Fabien-B/soufflerie_dashboard/soufflerie.kicad_pcb

## KiCad design soufflerie.kicad_pcb (2024-04-11)

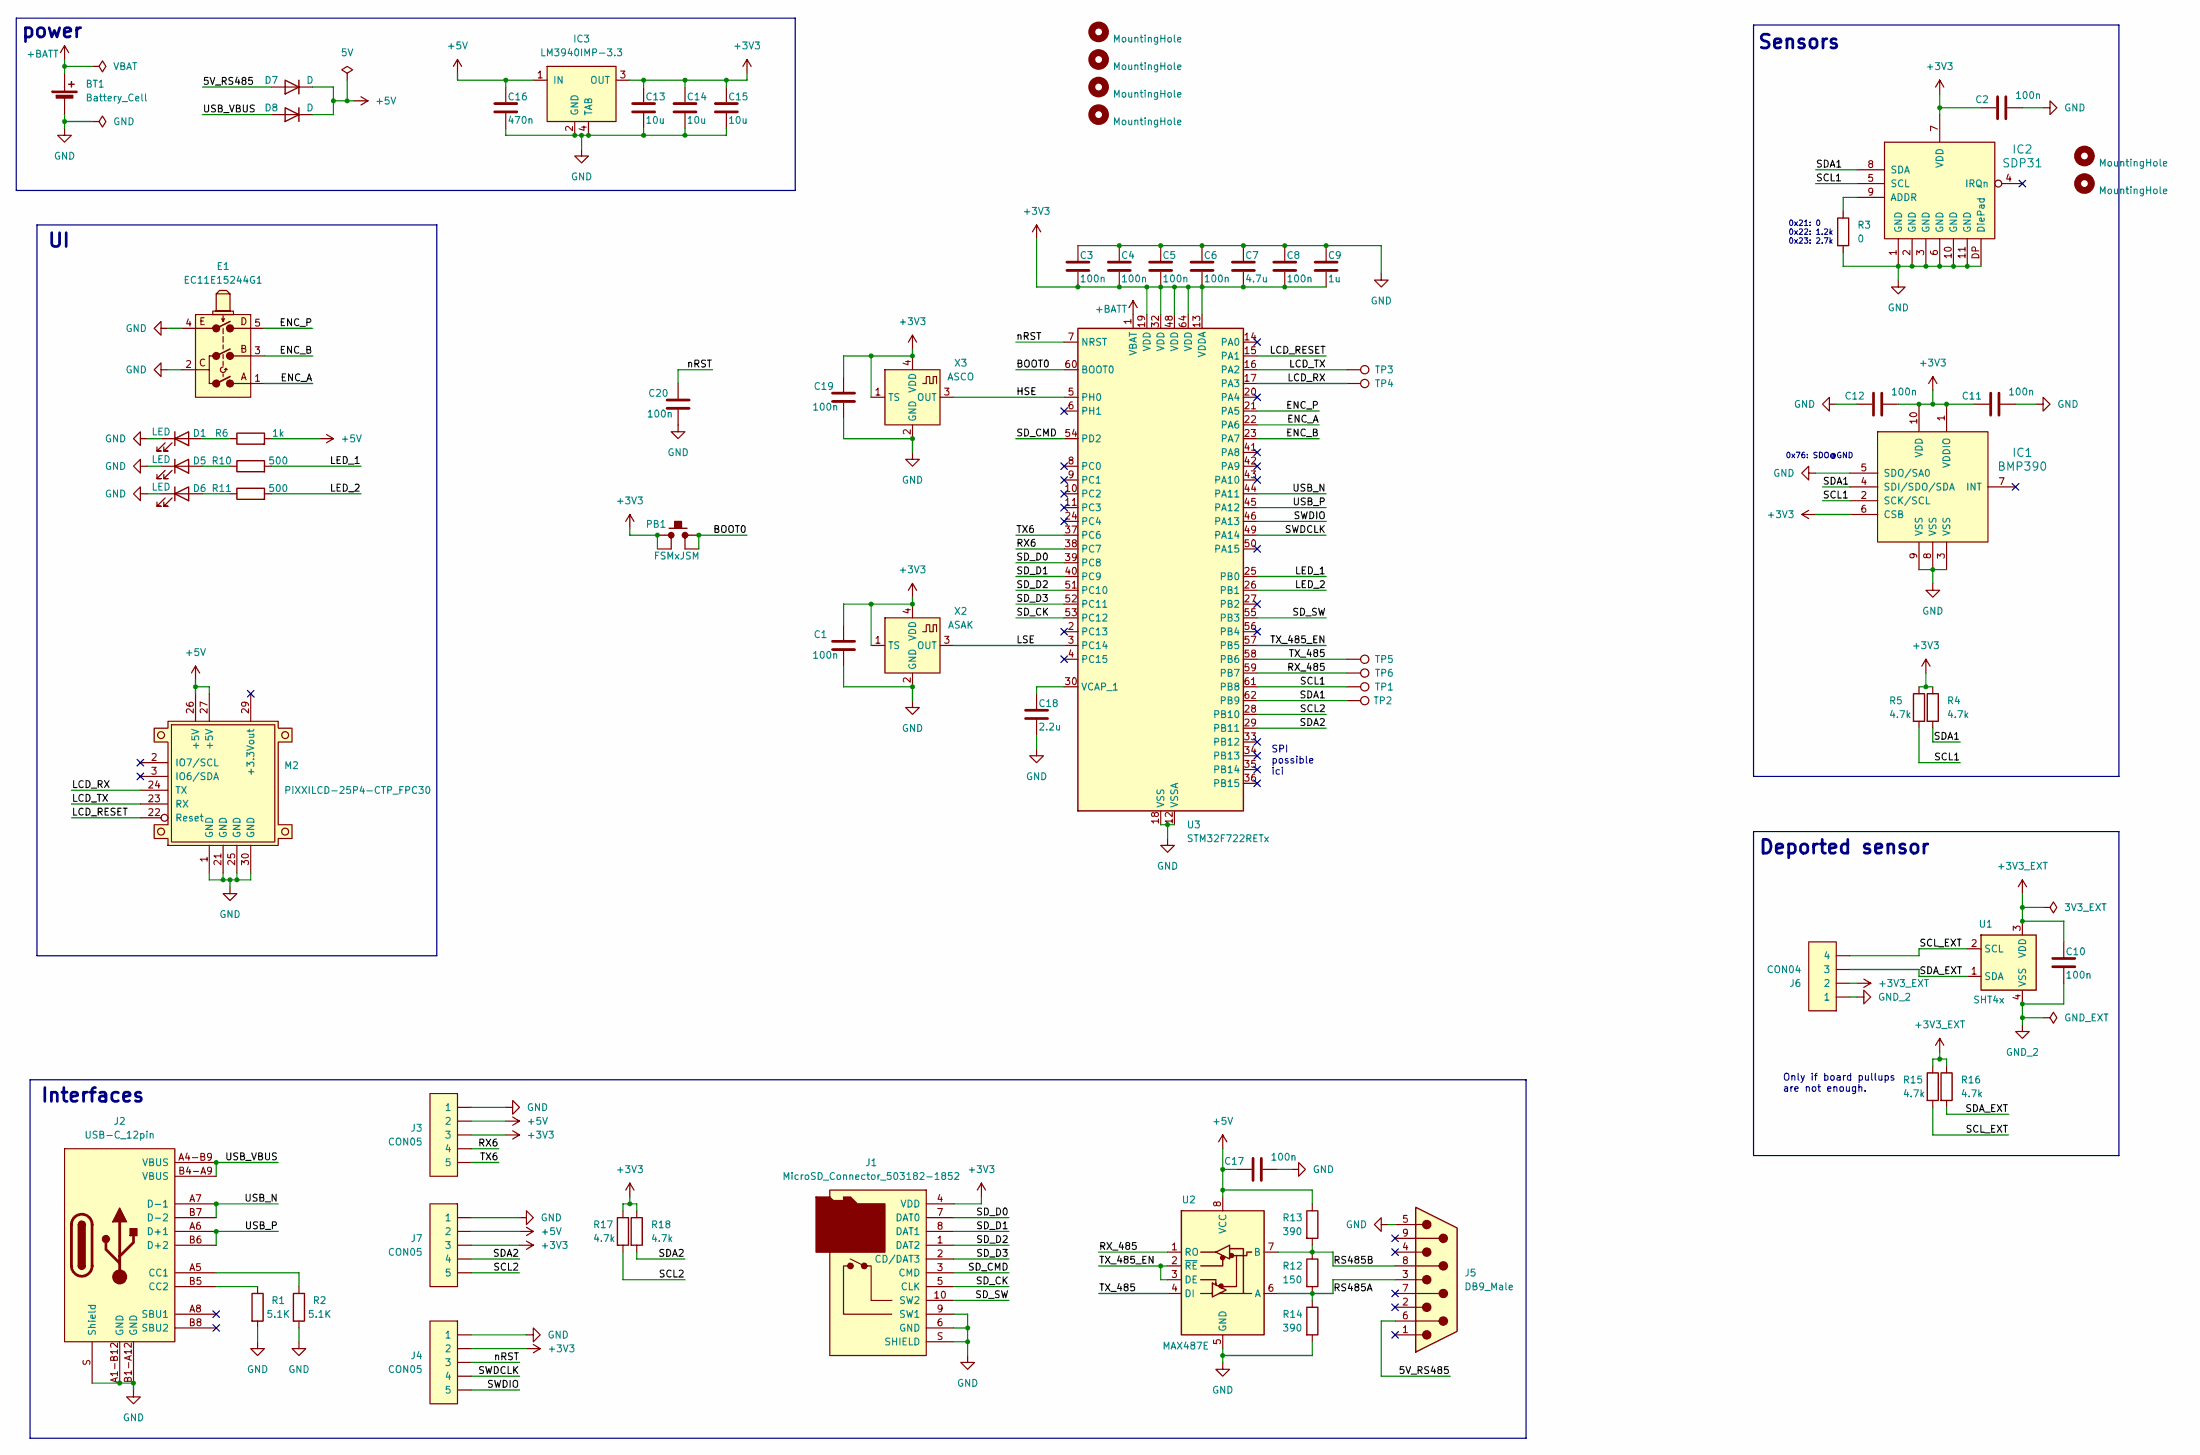
[picture p1: schematic soufflerie.kicad_sch]

Parts:
BT1: Battery_Cell; BatteryHolder_Keystone_3000_1x12mm
C1, C2, C3, C4, C5, C6, C8, C10, C11, C12, C17, C19, C20: 100n; C_0603_1608Metric
C7: 4.7u; C_0603_1608Metric
C9: 1u; C_0603_1608Metric
C13, C14, C15: 10u; C_0603_1608Metric
C16: 470n; C_0603_1608Metric
C18: 2.2u; C_0603_1608Metric
D1, D5, D6: LED; LED_0603_1608Metric
D7, D8: D; PMEG2010EB
E1: EC11E15244G1
H1, H2, H3, H4: MountingHole; MountingHole_3.2mm_M3
H5, H6: MountingHole; MountingHole_2.2mm_M2
IC1: BMP390
IC2: SDP31
IC3: LM3940IMP-3.3; LM3940IMP
J1: MicroSD_Connector_503182-1852; MicroSD_503182-1852
J2: USB-C_12pin; USB-C_HRO_C-31-M-12
J3, J4, J7: CON05; PicoBlade_53398-0571
J5: DB9_Male; DSUB-9_Male_Horizontal_P2.77x2.84mm_EdgePinOffset7.70mm_Hou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
J6: CON04; PicoBlade_53398-0471
M2: PIXXILCD-25P4-CTP_FPC30
PB1: FSMxJSM; FSM2JSM
R1, R2: 5.1K; R_0603_1608Metric
R3: 0; R_0603_1608Metric
R4, R5, R15, R16, R17, R18: 4.7k; R_0603_1608Metric
R6: 1k; R_0603_1608Metric
R10, R11: 500; R_0603_1608Metric
R12: 150; R_0603_1608Metric
R13, R14: 390; R_0603_1608Metric
TP1, TP2, TP3, TP4, TP5, TP6: TestPoint; TestPoint_Pad_D2.0mm
U1: SHT4x; Sensirion_DFN-4_1.5x1.5mm_P0.8mm_SHT4x_NoCentralPad
U2: MAX487E; SOIC-8_3.9x4.9mm_P1.27mm
U3: STM32F722RETx; LQFP-64_10x10mm_P0.5mm
X2: ASAK; Osc_ASAK
X3: ASCO; Osc_ASCO

Connections:
+3V3: C1.1, C2.1, C3.2, C4.2, C5.2, C6.2, C7.2, C8.2, C9.2, C11.1, C12.2, C13.1, C14.1, C15.1, C19.1, IC1.1 (VDDIO), IC1.6 (CSB), IC1.10 (VDD), IC2.7 (VDD), IC3.3 (OUT), J1.4 (VDD), J3.3, J4.2, J7.3, PB1.1, PB1.2, R4.1, R5.1, R17.1, R18.1, U3.13 (VDDA), U3.19 (VDD), U3.32 (VDD), U3.48 (VDD), U3.64 (VDD), X2.1 (TS), X2.4 (VDD), X3.1 (TS), X3.4 (VDD)
+3V3_EXT: C10.1, J6.2, R15.1, R16.1, U1.3 (VDD)
+5V: C16.1, C17.1, D7.1 (K), D8.1 (K), IC3.1 (IN), J3.2, J7.2, M2.26 (+5V), M2.27 (+5V), R6.2, R13.1, U2.8 (VCC)
+BATT: BT1.1 (+), U3.1 (VBAT)
/5V_RS485: D7.2 (A), J5.6
/BOOT0: PB1.3, PB1.4, U3.60 (BOOT0)
/ENC_A: E1.1, U3.22 (PA6)
/ENC_B: E1.3, U3.23 (PA7)
/ENC_P: E1.5, U3.21 (PA5)
/HSE: U3.5 (PH0), X3.3 (OUT)
/LCD_RESET: M2.22 (Reset), U3.15 (PA1)
/LCD_RX: M2.24 (TX), TP4.1, U3.17 (PA3)
/LCD_TX: M2.23 (RX), TP3.1, U3.16 (PA2)
/LED_1: R10.2, U3.25 (PB0)
/LED_2: R11.2, U3.26 (PB1)
/LSE: U3.3 (PC14), X2.3 (OUT)
/RS485A: J5.3, R12.2, R14.1, U2.6 (A)
/RS485B: J5.8, R12.1, R13.2, U2.7 (B)
/RX6: J3.4, U3.38 (PC7)
/RX_485: TP6.1, U2.1 (RO), U3.59 (PB7)
/SCL1: IC1.2 (SCK/SCL), IC2.5 (SCL), R5.2, TP1.1, U3.61 (PB8)
/SCL2: J7.5, R17.2, U3.28 (PB10)
/SCL_EXT: J6.4, R15.2, U1.2 (SCL)
/SDA1: IC1.4 (SDI/SDO/SDA), IC2.8 (SDA), R4.2, TP2.1, U3.62 (PB9)
/SDA2: J7.4, R18.2, U3.29 (PB11)
/SDA_EXT: J6.3, R16.2, U1.1 (SDA)
/SD_CK: J1.5 (CLK), U3.53 (PC12)
/SD_CMD: J1.3 (CMD), U3.54 (PD2)
/SD_D0: J1.7 (DAT0), U3.39 (PC8)
/SD_D1: J1.8 (DAT1), U3.40 (PC9)
/SD_D2: J1.1 (DAT2), U3.51 (PC10)
/SD_D3: J1.2 (CD/DAT3), U3.52 (PC11)
/SD_SW: J1.10 (SW2), U3.55 (PB3)
/SWDCLK: J4.4, U3.49 (PA14)
/SWDIO: J4.5, U3.46 (PA13)
/TX6: J3.5, U3.37 (PC6)
/TX_485: TP5.1, U2.4 (DI), U3.58 (PB6)
/TX_485_EN: U2.2 (~RE), U2.3 (DE), U3.57 (PB5)
/USB_N: J2.A7 (D-1), J2.B7 (D-2), U3.44 (PA11)
/USB_P: J2.A6 (D+1), J2.B6 (D+2), U3.45 (PA12)
/USB_VBUS: D8.2 (A), J2.A4-B9 (VBUS), J2.B4-A9 (VBUS)
/nRST: C20.1, J4.3, U3.7 (NRST)
GND: BT1.2 (-), C1.2, C2.2, C3.1, C4.1, C5.1, C6.1, C7.1, C8.1, C9.1, C11.2, C12.1, C13.2, C14.2, C15.2, C16.2, C17.2, C18.2, C19.2, C20.2, D1.1 (K), D5.1 (K), D6.1 (K), E1.2, E1.4, IC1.3 (VSS), IC1.5 (SDO/SA0), IC1.8 (VSS), IC1.9 (VSS), IC2.1 (GND), IC2.2 (GND), IC2.3 (GND), IC2.6 (GND), IC2.10 (GND), IC2.11 (GND), IC2.DP (DiePad), IC3.2 (GND), IC3.4 (TAB), J1.6 (GND), J1.9 (SW1), J1.S (SHIELD), J2.A1-B12 (GND), J2.B1-A12 (GND), J2.S (Shield), J3.1, J4.1, J5.5, J7.1, M2.1 (GND), M2.21 (GND), M2.25 (GND), M2.30 (GND), R1.2, R2.2, R3.2, R14.2, U2.5 (GND), U3.12 (VSSA), U3.18 (VSS), U3.31 (VSS), U3.47 (VSS), U3.63 (VSS), X2.2 (GND), X3.2 (GND)
GND_2: C10.2, J6.1, U1.4 (VSS)
unnamed: D1.2 (A), R6.1
unnamed: D5.2 (A), R10.1
unnamed: D6.2 (A), R11.1
unnamed: IC2.9 (ADDR), R3.1
unnamed: J2.A5 (CC1), R2.1
unnamed: J2.B5 (CC2), R1.1
unnamed: C18.1, U3.30 (VCAP_1)

Notes on the sheet:
Interfaces
Only if board pullups are not enough.
0x76: SDO@GND
SPI possible ici
0x21: 0 0x22: 1.2k 0x23: 2.7k
Sensors
Deported sensor
power

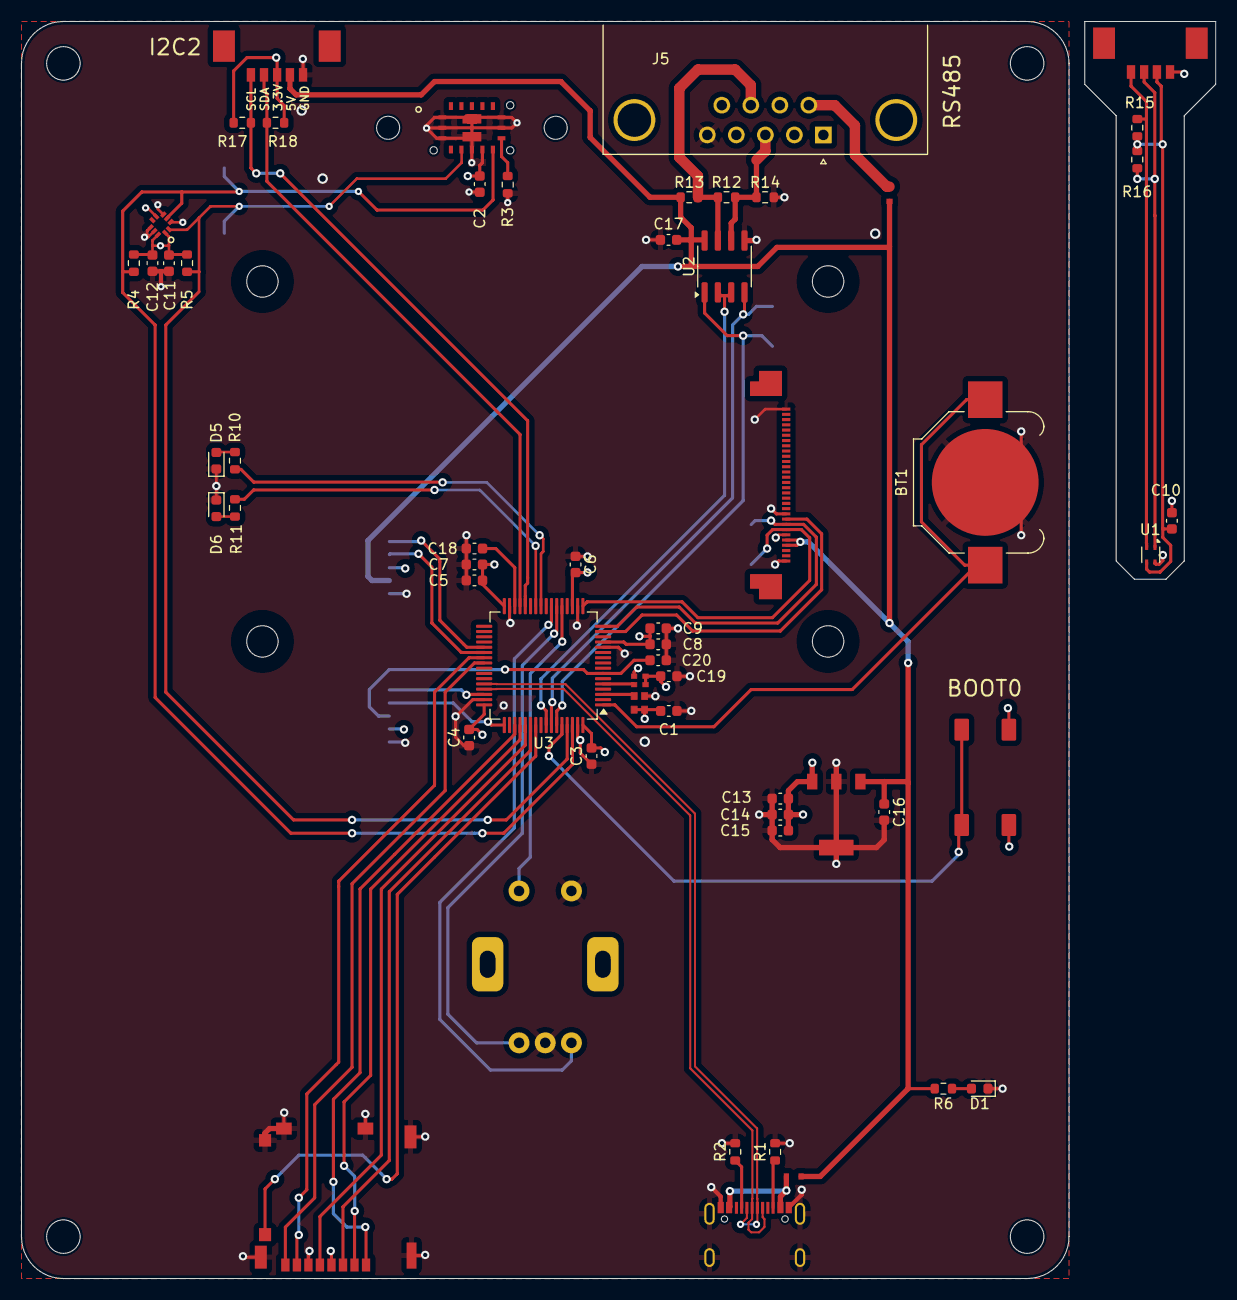
[picture p2: board soufflerie.kicad_pcb from above]

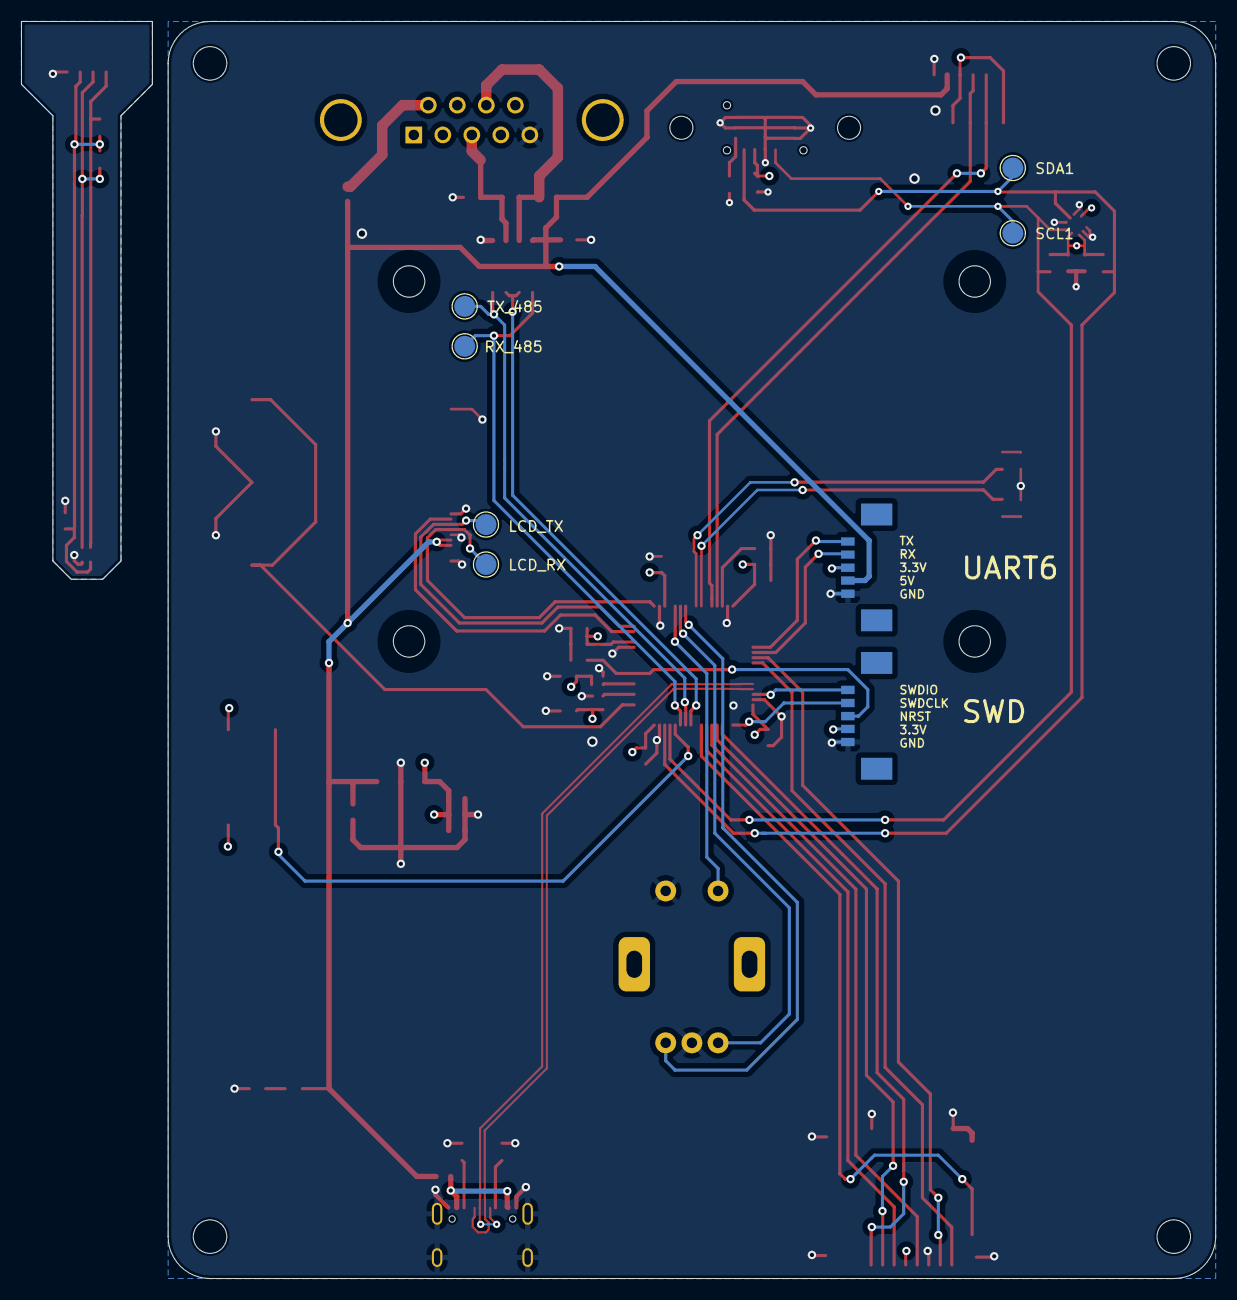
[picture p3: board soufflerie.kicad_pcb from below]

Board: 4 copper layers, 100.0 x 120.0 mm, 71 parts (8 on the bottom side), 51 nets.
