Fabien-B/soufflerie_dashboard/firmware/source/main.cpp

/*
    ChibiOS - Copyright (C) 2006..2018 Giovanni Di Sirio

    Licensed under the Apache License, Version 2.0 (the "License");
    you may not use this file except in compliance with the License.
    You may obtain a copy of the License at

        http://www.apache.org/licenses/LICENSE-2.0

    Unless required by applicable law or agreed to in writing, software
    distributed under the License is distributed on an "AS IS" BASIS,
    WITHOUT WARRANTIES OR CONDITIONS OF ANY KIND, either express or implied.
    See the License for the specific language governing permissions and
    limitations under the License.
*/

#include "ch.h"
#include "hal.h"
#include "display.h"
#include "stdutil++.hpp"
#include "sensors.h"
#include "sd.h"
#include "ttyConsole.h"
#include "uss_handler.h"


SerialConfig sd6_conf = {
  .speed = 115200,
  .cr1 = 0,
  .cr2 = USART_CR2_STOP1_BITS | USART_CR2_LINEN,
  .cr3 = 0
};


/*
 * This is a periodic thread that does absolutely nothing except flashing
 * a LED.
 */
static THD_WORKING_AREA(waThread1, 512);
static THD_FUNCTION(Thread1, arg) {

  (void)arg;
  chRegSetThreadName("blinker");

  while (true) {
    chThdSleepMilliseconds(200);
  }
}




/*
 * Application entry point.
 */
int main(void) {

  /*
   * System initializations.
   * - HAL initialization, this also initializes the configured device drivers
   *   and performs the board-specific initializations.
   * - Kernel initialization, the main() function becomes a thread and the
   *   RTOS is active.
   */
  halInit();
  chSysInit();
  initHeap();

  consoleInit();
  startSensors();
  startUSSListener();
  startUI();
  

  /*
   * Creates the example thread.
   */
  chThdCreateStatic(waThread1, sizeof(waThread1), NORMALPRIO + 1, Thread1, NULL);

  consoleLaunch();

  while (true) {
    chThdSleepMilliseconds(500);
  }
}
