Fabien-B/soufflerie_dashboard/firmware/cfg/board.h

/*
    ChibiOS - Copyright (C) 2006..2015 Giovanni Di Sirio

    Licensed under the Apache License, Version 2.0 (the "License");
    you may not use this file except in compliance with the License.
    You may obtain a copy of the License at

        http://www.apache.org/licenses/LICENSE-2.0

    Unless required by applicable law or agreed to in writing, software
    distributed under the License is distributed on an "AS IS" BASIS,
    WITHOUT WARRANTIES OR CONDITIONS OF ANY KIND, either express or implied.
    See the License for the specific language governing permissions and
    limitations under the License.
*/

#pragma once

/*
 * Board identifier.
 */
#define BOARD_SOUFFLERIE
#define BOARD_NAME                  "Soufflerie"

/*
 * Board oscillators-related settings.
 */
#if !defined(STM32_LSECLK)
#define STM32_LSECLK                32768
#define STM32_LSE_BYPASS           TRUE
#endif

#define STM32_LSEDRV                (3U << 3U)

#if !defined(STM32_HSECLK)
#define STM32_HSECLK                8000000U
#define STM32_HSE_BYPASS            TRUE
#endif


/*
 * Board voltages.
 * Required for performance limits calculation.
 */
#define STM32_VDD                   300U

/*
 * MCU type as defined in the ST header.
 */
#define STM32F722xx

/*
 * IO pins assignments.
 */
#define	PA00                           0U
#define	PA01_LCD_RESET                 1U
#define	PA02_LCD_TX                    2U
#define	PA03_LCD_RX                    3U
#define	PA04                           4U
#define	PA05_ENC_PUSH                  5U
#define	PA06_ENC_A                     6U
#define	PA07_ENC_B                     7U
#define	PA08                           8U
#define	PA09                           9U
#define	PA10                           10U
#define	PA11_USB_DM                    11U
#define	PA12_USB_DP                    12U
#define	PA13_SWDIO                     13U
#define	PA14_SWCLK                     14U
#define	PA15                           15U

#define	PB00_LED1                      0U
#define	PB01_LED2                      1U
#define	PB02                           2U
#define	PB03_SD_SW                     3U
#define	PB04                           4U
#define	PB05_TX485EN                   5U
#define	PB06_TX485                     6U
#define	PB07_RS485                     7U
#define	PB08_I2C1_SCL                  8U
#define	PB09_I2C1_SDA                  9U
#define	PB10_I2C2_SCL                  10U
#define	PB11_I2C2_SDA                  11U
#define	PB12                           12U
#define	PB13                           13U
#define	PB14                           14U
#define	PB15                           15U

#define	PC00                           0U
#define	PC01                           1U
#define	PC02                           2U
#define	PC03                           3U
#define	PC04                           4U
#define	PC05                           5U
#define	PC06_UART6_TX                  6U
#define	PC07_UART6_RX                  7U
#define	PC08_SD_D0                     8U
#define	PC09_SD_D1                     9U
#define	PC10_SD_D2                     10U
#define	PC11_SD_D3                     11U
#define	PC12_SD_CK                     12U
#define	PC13                           13U
#define	PC14_OSC32_IN                  14U
#define	PC15                           15U

#define	PD00                           0U
#define	PD01                           1U
#define	PD02_SD_CMD                    2U
#define	PD03                           3U
#define	PD04                           4U
#define	PD05                           5U
#define	PD06                           6U
#define	PD07                           7U
#define	PD08                           8U
#define	PD09                           9U
#define	PD10                           10U
#define	PD11                           11U
#define	PD12                           12U
#define	PD13                           13U
#define	PD14                           14U
#define	PD15                           15U

#define	PE00                           0U
#define	PE01                           1U
#define	PE02                           2U
#define	PE03                           3U
#define	PE04                           4U
#define	PE05                           5U
#define	PE06                           6U
#define	PE07                           7U
#define	PE08                           8U
#define	PE09                           9U
#define	PE10                           10U
#define	PE11                           11U
#define	PE12                           12U
#define	PE13                           13U
#define	PE14                           14U
#define	PE15                           15U

#define	PF00                           0U
#define	PF01                           1U
#define	PF02                           2U
#define	PF03                           3U
#define	PF04                           4U
#define	PF05                           5U
#define	PF06                           6U
#define	PF07                           7U
#define	PF08                           8U
#define	PF09                           9U
#define	PF10                           10U
#define	PF11                           11U
#define	PF12                           12U
#define	PF13                           13U
#define	PF14                           14U
#define	PF15                           15U

#define	PG00                           0U
#define	PG01                           1U
#define	PG02                           2U
#define	PG03                           3U
#define	PG04                           4U
#define	PG05                           5U
#define	PG06                           6U
#define	PG07                           7U
#define	PG08                           8U
#define	PG09                           9U
#define	PG10                           10U
#define	PG11                           11U
#define	PG12                           12U
#define	PG13                           13U
#define	PG14                           14U
#define	PG15                           15U

#define	PH00_OSC_IN                    0U
#define	PH01                           1U
#define	PH02                           2U
#define	PH03                           3U
#define	PH04                           4U
#define	PH05                           5U
#define	PH06                           6U
#define	PH07                           7U
#define	PH08                           8U
#define	PH09                           9U
#define	PH10                           10U
#define	PH11                           11U
#define	PH12                           12U
#define	PH13                           13U
#define	PH14                           14U
#define	PH15                           15U

#define	PI00                           0U
#define	PI01                           1U
#define	PI02                           2U
#define	PI03                           3U
#define	PI04                           4U
#define	PI05                           5U
#define	PI06                           6U
#define	PI07                           7U
#define	PI08                           8U
#define	PI09                           9U
#define	PI10                           10U
#define	PI11                           11U
#define	PI12                           12U
#define	PI13                           13U
#define	PI14                           14U
#define	PI15                           15U

#define	PJ00                           0U
#define	PJ01                           1U
#define	PJ02                           2U
#define	PJ03                           3U
#define	PJ04                           4U
#define	PJ05                           5U
#define	PJ06                           6U
#define	PJ07                           7U
#define	PJ08                           8U
#define	PJ09                           9U
#define	PJ10                           10U
#define	PJ11                           11U
#define	PJ12                           12U
#define	PJ13                           13U
#define	PJ14                           14U
#define	PJ15                           15U

#define	PK00                           0U
#define	PK01                           1U
#define	PK02                           2U
#define	PK03                           3U
#define	PK04                           4U
#define	PK05                           5U
#define	PK06                           6U
#define	PK07                           7U
#define	PK08                           8U
#define	PK09                           9U
#define	PK10                           10U
#define	PK11                           11U
#define	PK12                           12U
#define	PK13                           13U
#define	PK14                           14U
#define	PK15                           15U

/*
 * IO lines assignments.
 */
#define	LINE_LCD_RESET                 PAL_LINE(GPIOA, 1U)
#define	LINE_LCD_TX                    PAL_LINE(GPIOA, 2U)
#define	LINE_LCD_RX                    PAL_LINE(GPIOA, 3U)
#define	LINE_ENC_PUSH                  PAL_LINE(GPIOA, 5U)
#define	LINE_ENC_A                     PAL_LINE(GPIOA, 6U)
#define	LINE_ENC_B                     PAL_LINE(GPIOA, 7U)
#define	LINE_USB_DM                    PAL_LINE(GPIOA, 11U)
#define	LINE_USB_DP                    PAL_LINE(GPIOA, 12U)
#define	LINE_SWDIO                     PAL_LINE(GPIOA, 13U)
#define	LINE_SWCLK                     PAL_LINE(GPIOA, 14U)

#define	LINE_LED1                      PAL_LINE(GPIOB, 0U)
#define	LINE_LED2                      PAL_LINE(GPIOB, 1U)
#define	LINE_SD_SW                     PAL_LINE(GPIOB, 3U)
#define	LINE_TX485EN                   PAL_LINE(GPIOB, 5U)
#define	LINE_TX485                     PAL_LINE(GPIOB, 6U)
#define	LINE_RS485                     PAL_LINE(GPIOB, 7U)
#define	LINE_I2C1_SCL                  PAL_LINE(GPIOB, 8U)
#define	LINE_I2C1_SDA                  PAL_LINE(GPIOB, 9U)
#define	LINE_I2C2_SCL                  PAL_LINE(GPIOB, 10U)
#define	LINE_I2C2_SDA                  PAL_LINE(GPIOB, 11U)

#define	LINE_UART6_TX                  PAL_LINE(GPIOC, 6U)
#define	LINE_UART6_RX                  PAL_LINE(GPIOC, 7U)
#define	LINE_SD_D0                     PAL_LINE(GPIOC, 8U)
#define	LINE_SD_D1                     PAL_LINE(GPIOC, 9U)
#define	LINE_SD_D2                     PAL_LINE(GPIOC, 10U)
#define	LINE_SD_D3                     PAL_LINE(GPIOC, 11U)
#define	LINE_SD_CK                     PAL_LINE(GPIOC, 12U)
#define	LINE_OSC32_IN                  PAL_LINE(GPIOC, 14U)

#define	LINE_SD_CMD                    PAL_LINE(GPIOD, 2U)

#define	LINE_OSC_IN                    PAL_LINE(GPIOH, 0U)


/*
 * I/O ports initial setup, this configuration is established soon after reset
 * in the initialization code.
 * Please refer to the STM32 Reference Manual for details.
 */
#define PIN_MODE_INPUT(n)           (0U << ((n) * 2U))
#define PIN_MODE_OUTPUT(n)          (1U << ((n) * 2U))
#define PIN_MODE_ALTERNATE(n)       (2U << ((n) * 2U))
#define PIN_MODE_ANALOG(n)          (3U << ((n) * 2U))
#define PIN_ODR_LEVEL_LOW(n)        (0U << (n))
#define PIN_ODR_LEVEL_HIGH(n)       (1U << (n))
#define PIN_OTYPE_PUSHPULL(n)       (0U << (n))
#define PIN_OTYPE_OPENDRAIN(n)      (1U << (n))
#define PIN_OSPEED_SPEED_VERYLOW(n) (0U << ((n) * 2U))
#define PIN_OSPEED_SPEED_LOW(n)     (1U << ((n) * 2U))
#define PIN_OSPEED_SPEED_MEDIUM(n)  (2U << ((n) * 2U))
#define PIN_OSPEED_SPEED_HIGH(n)    (3U << ((n) * 2U))
#define PIN_PUPDR_FLOATING(n)       (0U << ((n) * 2U))
#define PIN_PUPDR_PULLUP(n)         (1U << ((n) * 2U))
#define PIN_PUPDR_PULLDOWN(n)       (2U << ((n) * 2U))
#define PIN_AFIO_AF(n, v)           ((v) << (((n) % 8U) * 4U))

#define VAL_GPIOA_MODER                 (PIN_MODE_INPUT(PA00) | \
					 PIN_MODE_OUTPUT(PA01_LCD_RESET) | \
					 PIN_MODE_ALTERNATE(PA02_LCD_TX) | \
					 PIN_MODE_ALTERNATE(PA03_LCD_RX) | \
					 PIN_MODE_INPUT(PA04) | \
					 PIN_MODE_INPUT(PA05_ENC_PUSH) | \
					 PIN_MODE_ALTERNATE(PA06_ENC_A) | \
					 PIN_MODE_ALTERNATE(PA07_ENC_B) | \
					 PIN_MODE_INPUT(PA08) | \
					 PIN_MODE_INPUT(PA09) | \
					 PIN_MODE_INPUT(PA10) | \
					 PIN_MODE_ALTERNATE(PA11_USB_DM) | \
					 PIN_MODE_ALTERNATE(PA12_USB_DP) | \
					 PIN_MODE_ALTERNATE(PA13_SWDIO) | \
					 PIN_MODE_ALTERNATE(PA14_SWCLK) | \
					 PIN_MODE_INPUT(PA15))

#define VAL_GPIOA_OTYPER                (PIN_OTYPE_PUSHPULL(PA00) | \
					 PIN_OTYPE_PUSHPULL(PA01_LCD_RESET) | \
					 PIN_OTYPE_PUSHPULL(PA02_LCD_TX) | \
					 PIN_OTYPE_PUSHPULL(PA03_LCD_RX) | \
					 PIN_OTYPE_PUSHPULL(PA04) | \
					 PIN_OTYPE_OPENDRAIN(PA05_ENC_PUSH) | \
					 PIN_OTYPE_PUSHPULL(PA06_ENC_A) | \
					 PIN_OTYPE_PUSHPULL(PA07_ENC_B) | \
					 PIN_OTYPE_PUSHPULL(PA08) | \
					 PIN_OTYPE_PUSHPULL(PA09) | \
					 PIN_OTYPE_PUSHPULL(PA10) | \
					 PIN_OTYPE_PUSHPULL(PA11_USB_DM) | \
					 PIN_OTYPE_PUSHPULL(PA12_USB_DP) | \
					 PIN_OTYPE_PUSHPULL(PA13_SWDIO) | \
					 PIN_OTYPE_PUSHPULL(PA14_SWCLK) | \
					 PIN_OTYPE_PUSHPULL(PA15))

#define VAL_GPIOA_OSPEEDR               (PIN_OSPEED_SPEED_VERYLOW(PA00) | \
					 PIN_OSPEED_SPEED_VERYLOW(PA01_LCD_RESET) | \
					 PIN_OSPEED_SPEED_HIGH(PA02_LCD_TX) | \
					 PIN_OSPEED_SPEED_HIGH(PA03_LCD_RX) | \
					 PIN_OSPEED_SPEED_VERYLOW(PA04) | \
					 PIN_OSPEED_SPEED_VERYLOW(PA05_ENC_PUSH) | \
					 PIN_OSPEED_SPEED_HIGH(PA06_ENC_A) | \
					 PIN_OSPEED_SPEED_HIGH(PA07_ENC_B) | \
					 PIN_OSPEED_SPEED_VERYLOW(PA08) | \
					 PIN_OSPEED_SPEED_VERYLOW(PA09) | \
					 PIN_OSPEED_SPEED_VERYLOW(PA10) | \
					 PIN_OSPEED_SPEED_HIGH(PA11_USB_DM) | \
					 PIN_OSPEED_SPEED_HIGH(PA12_USB_DP) | \
					 PIN_OSPEED_SPEED_HIGH(PA13_SWDIO) | \
					 PIN_OSPEED_SPEED_HIGH(PA14_SWCLK) | \
					 PIN_OSPEED_SPEED_VERYLOW(PA15))

#define VAL_GPIOA_PUPDR                 (PIN_PUPDR_PULLDOWN(PA00) | \
					 PIN_PUPDR_FLOATING(PA01_LCD_RESET) | \
					 PIN_PUPDR_FLOATING(PA02_LCD_TX) | \
					 PIN_PUPDR_FLOATING(PA03_LCD_RX) | \
					 PIN_PUPDR_PULLDOWN(PA04) | \
					 PIN_PUPDR_PULLUP(PA05_ENC_PUSH) | \
					 PIN_PUPDR_FLOATING(PA06_ENC_A) | \
					 PIN_PUPDR_FLOATING(PA07_ENC_B) | \
					 PIN_PUPDR_PULLDOWN(PA08) | \
					 PIN_PUPDR_PULLDOWN(PA09) | \
					 PIN_PUPDR_PULLDOWN(PA10) | \
					 PIN_PUPDR_FLOATING(PA11_USB_DM) | \
					 PIN_PUPDR_FLOATING(PA12_USB_DP) | \
					 PIN_PUPDR_PULLUP(PA13_SWDIO) | \
					 PIN_PUPDR_PULLUP(PA14_SWCLK) | \
					 PIN_PUPDR_PULLDOWN(PA15))

#define VAL_GPIOA_ODR                   (PIN_ODR_LEVEL_LOW(PA00) | \
					 PIN_ODR_LEVEL_HIGH(PA01_LCD_RESET) | \
					 PIN_ODR_LEVEL_HIGH(PA02_LCD_TX) | \
					 PIN_ODR_LEVEL_HIGH(PA03_LCD_RX) | \
					 PIN_ODR_LEVEL_LOW(PA04) | \
					 PIN_ODR_LEVEL_LOW(PA05_ENC_PUSH) | \
					 PIN_ODR_LEVEL_HIGH(PA06_ENC_A) | \
					 PIN_ODR_LEVEL_HIGH(PA07_ENC_B) | \
					 PIN_ODR_LEVEL_LOW(PA08) | \
					 PIN_ODR_LEVEL_LOW(PA09) | \
					 PIN_ODR_LEVEL_LOW(PA10) | \
					 PIN_ODR_LEVEL_HIGH(PA11_USB_DM) | \
					 PIN_ODR_LEVEL_HIGH(PA12_USB_DP) | \
					 PIN_ODR_LEVEL_HIGH(PA13_SWDIO) | \
					 PIN_ODR_LEVEL_HIGH(PA14_SWCLK) | \
					 PIN_ODR_LEVEL_LOW(PA15))

#define VAL_GPIOA_AFRL			(PIN_AFIO_AF(PA00, 0) | \
					 PIN_AFIO_AF(PA01_LCD_RESET, 0) | \
					 PIN_AFIO_AF(PA02_LCD_TX, 7) | \
					 PIN_AFIO_AF(PA03_LCD_RX, 7) | \
					 PIN_AFIO_AF(PA04, 0) | \
					 PIN_AFIO_AF(PA05_ENC_PUSH, 0) | \
					 PIN_AFIO_AF(PA06_ENC_A, 2) | \
					 PIN_AFIO_AF(PA07_ENC_B, 2))

#define VAL_GPIOA_AFRH			(PIN_AFIO_AF(PA08, 0) | \
					 PIN_AFIO_AF(PA09, 0) | \
					 PIN_AFIO_AF(PA10, 0) | \
					 PIN_AFIO_AF(PA11_USB_DM, 10) | \
					 PIN_AFIO_AF(PA12_USB_DP, 10) | \
					 PIN_AFIO_AF(PA13_SWDIO, 0) | \
					 PIN_AFIO_AF(PA14_SWCLK, 0) | \
					 PIN_AFIO_AF(PA15, 0))

#define VAL_GPIOB_MODER                 (PIN_MODE_OUTPUT(PB00_LED1) | \
					 PIN_MODE_OUTPUT(PB01_LED2) | \
					 PIN_MODE_INPUT(PB02) | \
					 PIN_MODE_INPUT(PB03_SD_SW) | \
					 PIN_MODE_INPUT(PB04) | \
					 PIN_MODE_OUTPUT(PB05_TX485EN) | \
					 PIN_MODE_ALTERNATE(PB06_TX485) | \
					 PIN_MODE_ALTERNATE(PB07_RS485) | \
					 PIN_MODE_ALTERNATE(PB08_I2C1_SCL) | \
					 PIN_MODE_ALTERNATE(PB09_I2C1_SDA) | \
					 PIN_MODE_ALTERNATE(PB10_I2C2_SCL) | \
					 PIN_MODE_ALTERNATE(PB11_I2C2_SDA) | \
					 PIN_MODE_INPUT(PB12) | \
					 PIN_MODE_INPUT(PB13) | \
					 PIN_MODE_INPUT(PB14) | \
					 PIN_MODE_INPUT(PB15))

#define VAL_GPIOB_OTYPER                (PIN_OTYPE_PUSHPULL(PB00_LED1) | \
					 PIN_OTYPE_PUSHPULL(PB01_LED2) | \
					 PIN_OTYPE_PUSHPULL(PB02) | \
					 PIN_OTYPE_OPENDRAIN(PB03_SD_SW) | \
					 PIN_OTYPE_PUSHPULL(PB04) | \
					 PIN_OTYPE_PUSHPULL(PB05_TX485EN) | \
					 PIN_OTYPE_PUSHPULL(PB06_TX485) | \
					 PIN_OTYPE_PUSHPULL(PB07_RS485) | \
					 PIN_OTYPE_OPENDRAIN(PB08_I2C1_SCL) | \
					 PIN_OTYPE_OPENDRAIN(PB09_I2C1_SDA) | \
					 PIN_OTYPE_OPENDRAIN(PB10_I2C2_SCL) | \
					 PIN_OTYPE_OPENDRAIN(PB11_I2C2_SDA) | \
					 PIN_OTYPE_PUSHPULL(PB12) | \
					 PIN_OTYPE_PUSHPULL(PB13) | \
					 PIN_OTYPE_PUSHPULL(PB14) | \
					 PIN_OTYPE_PUSHPULL(PB15))

#define VAL_GPIOB_OSPEEDR               (PIN_OSPEED_SPEED_VERYLOW(PB00_LED1) | \
					 PIN_OSPEED_SPEED_VERYLOW(PB01_LED2) | \
					 PIN_OSPEED_SPEED_VERYLOW(PB02) | \
					 PIN_OSPEED_SPEED_VERYLOW(PB03_SD_SW) | \
					 PIN_OSPEED_SPEED_VERYLOW(PB04) | \
					 PIN_OSPEED_SPEED_VERYLOW(PB05_TX485EN) | \
					 PIN_OSPEED_SPEED_HIGH(PB06_TX485) | \
					 PIN_OSPEED_SPEED_HIGH(PB07_RS485) | \
					 PIN_OSPEED_SPEED_HIGH(PB08_I2C1_SCL) | \
					 PIN_OSPEED_SPEED_HIGH(PB09_I2C1_SDA) | \
					 PIN_OSPEED_SPEED_HIGH(PB10_I2C2_SCL) | \
					 PIN_OSPEED_SPEED_HIGH(PB11_I2C2_SDA) | \
					 PIN_OSPEED_SPEED_VERYLOW(PB12) | \
					 PIN_OSPEED_SPEED_VERYLOW(PB13) | \
					 PIN_OSPEED_SPEED_VERYLOW(PB14) | \
					 PIN_OSPEED_SPEED_VERYLOW(PB15))

#define VAL_GPIOB_PUPDR                 (PIN_PUPDR_FLOATING(PB00_LED1) | \
					 PIN_PUPDR_FLOATING(PB01_LED2) | \
					 PIN_PUPDR_PULLDOWN(PB02) | \
					 PIN_PUPDR_PULLUP(PB03_SD_SW) | \
					 PIN_PUPDR_PULLDOWN(PB04) | \
					 PIN_PUPDR_FLOATING(PB05_TX485EN) | \
					 PIN_PUPDR_FLOATING(PB06_TX485) | \
					 PIN_PUPDR_PULLUP(PB07_RS485) | \
					 PIN_PUPDR_PULLUP(PB08_I2C1_SCL) | \
					 PIN_PUPDR_PULLUP(PB09_I2C1_SDA) | \
					 PIN_PUPDR_PULLUP(PB10_I2C2_SCL) | \
					 PIN_PUPDR_PULLUP(PB11_I2C2_SDA) | \
					 PIN_PUPDR_PULLDOWN(PB12) | \
					 PIN_PUPDR_PULLDOWN(PB13) | \
					 PIN_PUPDR_PULLDOWN(PB14) | \
					 PIN_PUPDR_PULLDOWN(PB15))

#define VAL_GPIOB_ODR                   (PIN_ODR_LEVEL_LOW(PB00_LED1) | \
					 PIN_ODR_LEVEL_LOW(PB01_LED2) | \
					 PIN_ODR_LEVEL_LOW(PB02) | \
					 PIN_ODR_LEVEL_LOW(PB03_SD_SW) | \
					 PIN_ODR_LEVEL_LOW(PB04) | \
					 PIN_ODR_LEVEL_LOW(PB05_TX485EN) | \
					 PIN_ODR_LEVEL_HIGH(PB06_TX485) | \
					 PIN_ODR_LEVEL_HIGH(PB07_RS485) | \
					 PIN_ODR_LEVEL_HIGH(PB08_I2C1_SCL) | \
					 PIN_ODR_LEVEL_HIGH(PB09_I2C1_SDA) | \
					 PIN_ODR_LEVEL_HIGH(PB10_I2C2_SCL) | \
					 PIN_ODR_LEVEL_HIGH(PB11_I2C2_SDA) | \
					 PIN_ODR_LEVEL_LOW(PB12) | \
					 PIN_ODR_LEVEL_LOW(PB13) | \
					 PIN_ODR_LEVEL_LOW(PB14) | \
					 PIN_ODR_LEVEL_LOW(PB15))

#define VAL_GPIOB_AFRL			(PIN_AFIO_AF(PB00_LED1, 0) | \
					 PIN_AFIO_AF(PB01_LED2, 0) | \
					 PIN_AFIO_AF(PB02, 0) | \
					 PIN_AFIO_AF(PB03_SD_SW, 0) | \
					 PIN_AFIO_AF(PB04, 0) | \
					 PIN_AFIO_AF(PB05_TX485EN, 0) | \
					 PIN_AFIO_AF(PB06_TX485, 7) | \
					 PIN_AFIO_AF(PB07_RS485, 7))

#define VAL_GPIOB_AFRH			(PIN_AFIO_AF(PB08_I2C1_SCL, 4) | \
					 PIN_AFIO_AF(PB09_I2C1_SDA, 4) | \
					 PIN_AFIO_AF(PB10_I2C2_SCL, 4) | \
					 PIN_AFIO_AF(PB11_I2C2_SDA, 4) | \
					 PIN_AFIO_AF(PB12, 0) | \
					 PIN_AFIO_AF(PB13, 0) | \
					 PIN_AFIO_AF(PB14, 0) | \
					 PIN_AFIO_AF(PB15, 0))

#define VAL_GPIOC_MODER                 (PIN_MODE_INPUT(PC00) | \
					 PIN_MODE_INPUT(PC01) | \
					 PIN_MODE_INPUT(PC02) | \
					 PIN_MODE_INPUT(PC03) | \
					 PIN_MODE_INPUT(PC04) | \
					 PIN_MODE_INPUT(PC05) | \
					 PIN_MODE_ALTERNATE(PC06_UART6_TX) | \
					 PIN_MODE_ALTERNATE(PC07_UART6_RX) | \
					 PIN_MODE_ALTERNATE(PC08_SD_D0) | \
					 PIN_MODE_ALTERNATE(PC09_SD_D1) | \
					 PIN_MODE_ALTERNATE(PC10_SD_D2) | \
					 PIN_MODE_ALTERNATE(PC11_SD_D3) | \
					 PIN_MODE_ALTERNATE(PC12_SD_CK) | \
					 PIN_MODE_INPUT(PC13) | \
					 PIN_MODE_ALTERNATE(PC14_OSC32_IN) | \
					 PIN_MODE_INPUT(PC15))

#define VAL_GPIOC_OTYPER                (PIN_OTYPE_PUSHPULL(PC00) | \
					 PIN_OTYPE_PUSHPULL(PC01) | \
					 PIN_OTYPE_PUSHPULL(PC02) | \
					 PIN_OTYPE_PUSHPULL(PC03) | \
					 PIN_OTYPE_PUSHPULL(PC04) | \
					 PIN_OTYPE_PUSHPULL(PC05) | \
					 PIN_OTYPE_PUSHPULL(PC06_UART6_TX) | \
					 PIN_OTYPE_PUSHPULL(PC07_UART6_RX) | \
					 PIN_OTYPE_PUSHPULL(PC08_SD_D0) | \
					 PIN_OTYPE_PUSHPULL(PC09_SD_D1) | \
					 PIN_OTYPE_PUSHPULL(PC10_SD_D2) | \
					 PIN_OTYPE_PUSHPULL(PC11_SD_D3) | \
					 PIN_OTYPE_PUSHPULL(PC12_SD_CK) | \
					 PIN_OTYPE_PUSHPULL(PC13) | \
					 PIN_OTYPE_PUSHPULL(PC14_OSC32_IN) | \
					 PIN_OTYPE_PUSHPULL(PC15))

#define VAL_GPIOC_OSPEEDR               (PIN_OSPEED_SPEED_VERYLOW(PC00) | \
					 PIN_OSPEED_SPEED_VERYLOW(PC01) | \
					 PIN_OSPEED_SPEED_VERYLOW(PC02) | \
					 PIN_OSPEED_SPEED_VERYLOW(PC03) | \
					 PIN_OSPEED_SPEED_VERYLOW(PC04) | \
					 PIN_OSPEED_SPEED_VERYLOW(PC05) | \
					 PIN_OSPEED_SPEED_HIGH(PC06_UART6_TX) | \
					 PIN_OSPEED_SPEED_HIGH(PC07_UART6_RX) | \
					 PIN_OSPEED_SPEED_HIGH(PC08_SD_D0) | \
					 PIN_OSPEED_SPEED_HIGH(PC09_SD_D1) | \
					 PIN_OSPEED_SPEED_HIGH(PC10_SD_D2) | \
					 PIN_OSPEED_SPEED_HIGH(PC11_SD_D3) | \
					 PIN_OSPEED_SPEED_HIGH(PC12_SD_CK) | \
					 PIN_OSPEED_SPEED_VERYLOW(PC13) | \
					 PIN_OSPEED_SPEED_HIGH(PC14_OSC32_IN) | \
					 PIN_OSPEED_SPEED_VERYLOW(PC15))

#define VAL_GPIOC_PUPDR                 (PIN_PUPDR_PULLDOWN(PC00) | \
					 PIN_PUPDR_PULLDOWN(PC01) | \
					 PIN_PUPDR_PULLDOWN(PC02) | \
					 PIN_PUPDR_PULLDOWN(PC03) | \
					 PIN_PUPDR_PULLDOWN(PC04) | \
					 PIN_PUPDR_PULLDOWN(PC05) | \
					 PIN_PUPDR_FLOATING(PC06_UART6_TX) | \
					 PIN_PUPDR_FLOATING(PC07_UART6_RX) | \
					 PIN_PUPDR_PULLUP(PC08_SD_D0) | \
					 PIN_PUPDR_PULLUP(PC09_SD_D1) | \
					 PIN_PUPDR_PULLUP(PC10_SD_D2) | \
					 PIN_PUPDR_PULLUP(PC11_SD_D3) | \
					 PIN_PUPDR_PULLUP(PC12_SD_CK) | \
					 PIN_PUPDR_PULLDOWN(PC13) | \
					 PIN_PUPDR_FLOATING(PC14_OSC32_IN) | \
					 PIN_PUPDR_PULLDOWN(PC15))

#define VAL_GPIOC_ODR                   (PIN_ODR_LEVEL_LOW(PC00) | \
					 PIN_ODR_LEVEL_LOW(PC01) | \
					 PIN_ODR_LEVEL_LOW(PC02) | \
					 PIN_ODR_LEVEL_LOW(PC03) | \
					 PIN_ODR_LEVEL_LOW(PC04) | \
					 PIN_ODR_LEVEL_LOW(PC05) | \
					 PIN_ODR_LEVEL_HIGH(PC06_UART6_TX) | \
					 PIN_ODR_LEVEL_HIGH(PC07_UART6_RX) | \
					 PIN_ODR_LEVEL_HIGH(PC08_SD_D0) | \
					 PIN_ODR_LEVEL_HIGH(PC09_SD_D1) | \
					 PIN_ODR_LEVEL_HIGH(PC10_SD_D2) | \
					 PIN_ODR_LEVEL_HIGH(PC11_SD_D3) | \
					 PIN_ODR_LEVEL_HIGH(PC12_SD_CK) | \
					 PIN_ODR_LEVEL_LOW(PC13) | \
					 PIN_ODR_LEVEL_HIGH(PC14_OSC32_IN) | \
					 PIN_ODR_LEVEL_LOW(PC15))

#define VAL_GPIOC_AFRL			(PIN_AFIO_AF(PC00, 0) | \
					 PIN_AFIO_AF(PC01, 0) | \
					 PIN_AFIO_AF(PC02, 0) | \
					 PIN_AFIO_AF(PC03, 0) | \
					 PIN_AFIO_AF(PC04, 0) | \
					 PIN_AFIO_AF(PC05, 0) | \
					 PIN_AFIO_AF(PC06_UART6_TX, 8) | \
					 PIN_AFIO_AF(PC07_UART6_RX, 8))

#define VAL_GPIOC_AFRH			(PIN_AFIO_AF(PC08_SD_D0, 12) | \
					 PIN_AFIO_AF(PC09_SD_D1, 12) | \
					 PIN_AFIO_AF(PC10_SD_D2, 12) | \
					 PIN_AFIO_AF(PC11_SD_D3, 12) | \
					 PIN_AFIO_AF(PC12_SD_CK, 12) | \
					 PIN_AFIO_AF(PC13, 0) | \
					 PIN_AFIO_AF(PC14_OSC32_IN, 0) | \
					 PIN_AFIO_AF(PC15, 0))

#define VAL_GPIOD_MODER                 (PIN_MODE_INPUT(PD00) | \
					 PIN_MODE_INPUT(PD01) | \
					 PIN_MODE_ALTERNATE(PD02_SD_CMD) | \
					 PIN_MODE_INPUT(PD03) | \
					 PIN_MODE_INPUT(PD04) | \
					 PIN_MODE_INPUT(PD05) | \
					 PIN_MODE_INPUT(PD06) | \
					 PIN_MODE_INPUT(PD07) | \
					 PIN_MODE_INPUT(PD08) | \
					 PIN_MODE_INPUT(PD09) | \
					 PIN_MODE_INPUT(PD10) | \
					 PIN_MODE_INPUT(PD11) | \
					 PIN_MODE_INPUT(PD12) | \
					 PIN_MODE_INPUT(PD13) | \
					 PIN_MODE_INPUT(PD14) | \
					 PIN_MODE_INPUT(PD15))

#define VAL_GPIOD_OTYPER                (PIN_OTYPE_PUSHPULL(PD00) | \
					 PIN_OTYPE_PUSHPULL(PD01) | \
					 PIN_OTYPE_PUSHPULL(PD02_SD_CMD) | \
					 PIN_OTYPE_PUSHPULL(PD03) | \
					 PIN_OTYPE_PUSHPULL(PD04) | \
					 PIN_OTYPE_PUSHPULL(PD05) | \
					 PIN_OTYPE_PUSHPULL(PD06) | \
					 PIN_OTYPE_PUSHPULL(PD07) | \
					 PIN_OTYPE_PUSHPULL(PD08) | \
					 PIN_OTYPE_PUSHPULL(PD09) | \
					 PIN_OTYPE_PUSHPULL(PD10) | \
					 PIN_OTYPE_PUSHPULL(PD11) | \
					 PIN_OTYPE_PUSHPULL(PD12) | \
					 PIN_OTYPE_PUSHPULL(PD13) | \
					 PIN_OTYPE_PUSHPULL(PD14) | \
					 PIN_OTYPE_PUSHPULL(PD15))

#define VAL_GPIOD_OSPEEDR               (PIN_OSPEED_SPEED_VERYLOW(PD00) | \
					 PIN_OSPEED_SPEED_VERYLOW(PD01) | \
					 PIN_OSPEED_SPEED_HIGH(PD02_SD_CMD) | \
					 PIN_OSPEED_SPEED_VERYLOW(PD03) | \
					 PIN_OSPEED_SPEED_VERYLOW(PD04) | \
					 PIN_OSPEED_SPEED_VERYLOW(PD05) | \
					 PIN_OSPEED_SPEED_VERYLOW(PD06) | \
					 PIN_OSPEED_SPEED_VERYLOW(PD07) | \
					 PIN_OSPEED_SPEED_VERYLOW(PD08) | \
					 PIN_OSPEED_SPEED_VERYLOW(PD09) | \
					 PIN_OSPEED_SPEED_VERYLOW(PD10) | \
					 PIN_OSPEED_SPEED_VERYLOW(PD11) | \
					 PIN_OSPEED_SPEED_VERYLOW(PD12) | \
					 PIN_OSPEED_SPEED_VERYLOW(PD13) | \
					 PIN_OSPEED_SPEED_VERYLOW(PD14) | \
					 PIN_OSPEED_SPEED_VERYLOW(PD15))

#define VAL_GPIOD_PUPDR                 (PIN_PUPDR_PULLDOWN(PD00) | \
					 PIN_PUPDR_PULLDOWN(PD01) | \
					 PIN_PUPDR_PULLUP(PD02_SD_CMD) | \
					 PIN_PUPDR_PULLDOWN(PD03) | \
					 PIN_PUPDR_PULLDOWN(PD04) | \
					 PIN_PUPDR_PULLDOWN(PD05) | \
					 PIN_PUPDR_PULLDOWN(PD06) | \
					 PIN_PUPDR_PULLDOWN(PD07) | \
					 PIN_PUPDR_PULLDOWN(PD08) | \
					 PIN_PUPDR_PULLDOWN(PD09) | \
					 PIN_PUPDR_PULLDOWN(PD10) | \
					 PIN_PUPDR_PULLDOWN(PD11) | \
					 PIN_PUPDR_PULLDOWN(PD12) | \
					 PIN_PUPDR_PULLDOWN(PD13) | \
					 PIN_PUPDR_PULLDOWN(PD14) | \
					 PIN_PUPDR_PULLDOWN(PD15))

#define VAL_GPIOD_ODR                   (PIN_ODR_LEVEL_LOW(PD00) | \
					 PIN_ODR_LEVEL_LOW(PD01) | \
					 PIN_ODR_LEVEL_HIGH(PD02_SD_CMD) | \
					 PIN_ODR_LEVEL_LOW(PD03) | \
					 PIN_ODR_LEVEL_LOW(PD04) | \
					 PIN_ODR_LEVEL_LOW(PD05) | \
					 PIN_ODR_LEVEL_LOW(PD06) | \
					 PIN_ODR_LEVEL_LOW(PD07) | \
					 PIN_ODR_LEVEL_LOW(PD08) | \
					 PIN_ODR_LEVEL_LOW(PD09) | \
					 PIN_ODR_LEVEL_LOW(PD10) | \
					 PIN_ODR_LEVEL_LOW(PD11) | \
					 PIN_ODR_LEVEL_LOW(PD12) | \
					 PIN_ODR_LEVEL_LOW(PD13) | \
					 PIN_ODR_LEVEL_LOW(PD14) | \
					 PIN_ODR_LEVEL_LOW(PD15))

#define VAL_GPIOD_AFRL			(PIN_AFIO_AF(PD00, 0) | \
					 PIN_AFIO_AF(PD01, 0) | \
					 PIN_AFIO_AF(PD02_SD_CMD, 12) | \
					 PIN_AFIO_AF(PD03, 0) | \
					 PIN_AFIO_AF(PD04, 0) | \
					 PIN_AFIO_AF(PD05, 0) | \
					 PIN_AFIO_AF(PD06, 0) | \
					 PIN_AFIO_AF(PD07, 0))

#define VAL_GPIOD_AFRH			(PIN_AFIO_AF(PD08, 0) | \
					 PIN_AFIO_AF(PD09, 0) | \
					 PIN_AFIO_AF(PD10, 0) | \
					 PIN_AFIO_AF(PD11, 0) | \
					 PIN_AFIO_AF(PD12, 0) | \
					 PIN_AFIO_AF(PD13, 0) | \
					 PIN_AFIO_AF(PD14, 0) | \
					 PIN_AFIO_AF(PD15, 0))

#define VAL_GPIOE_MODER                 (PIN_MODE_INPUT(PE00) | \
					 PIN_MODE_INPUT(PE01) | \
					 PIN_MODE_INPUT(PE02) | \
					 PIN_MODE_INPUT(PE03) | \
					 PIN_MODE_INPUT(PE04) | \
					 PIN_MODE_INPUT(PE05) | \
					 PIN_MODE_INPUT(PE06) | \
					 PIN_MODE_INPUT(PE07) | \
					 PIN_MODE_INPUT(PE08) | \
					 PIN_MODE_INPUT(PE09) | \
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
					 PIN_MODE_INPUT(PK07) | \
					 PIN_MODE_INPUT(PK08) | \
					 PIN_MODE_INPUT(PK09) | \
					 PIN_MODE_INPUT(PK10) | \
					 PIN_MODE_INPUT(PK11) | \
					 PIN_MODE_INPUT(PK12) | \
					 PIN_MODE_INPUT(PK13) | \
					 PIN_MODE_INPUT(PK14) | \
					 PIN_MODE_INPUT(PK15))

#define VAL_GPIOK_OTYPER                (PIN_OTYPE_PUSHPULL(PK00) | \
					 PIN_OTYPE_PUSHPULL(PK01) | \
					 PIN_OTYPE_PUSHPULL(PK02) | \
					 PIN_OTYPE_PUSHPULL(PK03) | \
					 PIN_OTYPE_PUSHPULL(PK04) | \
					 PIN_OTYPE_PUSHPULL(PK05) | \
					 PIN_OTYPE_PUSHPULL(PK06) | \
					 PIN_OTYPE_PUSHPULL(PK07) | \
					 PIN_OTYPE_PUSHPULL(PK08) | \
					 PIN_OTYPE_PUSHPULL(PK09) | \
					 PIN_OTYPE_PUSHPULL(PK10) | \
					 PIN_OTYPE_PUSHPULL(PK11) | \
					 PIN_OTYPE_PUSHPULL(PK12) | \
					 PIN_OTYPE_PUSHPULL(PK13) | \
					 PIN_OTYPE_PUSHPULL(PK14) | \
					 PIN_OTYPE_PUSHPULL(PK15))

#define VAL_GPIOK_OSPEEDR               (PIN_OSPEED_SPEED_VERYLOW(PK00) | \
					 PIN_OSPEED_SPEED_VERYLOW(PK01) | \
					 PIN_OSPEED_SPEED_VERYLOW(PK02) | \
					 PIN_OSPEED_SPEED_VERYLOW(PK03) | \
					 PIN_OSPEED_SPEED_VERYLOW(PK04) | \
					 PIN_OSPEED_SPEED_VERYLOW(PK05) | \
					 PIN_OSPEED_SPEED_VERYLOW(PK06) | \
					 PIN_OSPEED_SPEED_VERYLOW(PK07) | \
					 PIN_OSPEED_SPEED_VERYLOW(PK08) | \
					 PIN_OSPEED_SPEED_VERYLOW(PK09) | \
					 PIN_OSPEED_SPEED_VERYLOW(PK10) | \
					 PIN_OSPEED_SPEED_VERYLOW(PK11) | \
					 PIN_OSPEED_SPEED_VERYLOW(PK12) | \
					 PIN_OSPEED_SPEED_VERYLOW(PK13) | \
					 PIN_OSPEED_SPEED_VERYLOW(PK14) | \
					 PIN_OSPEED_SPEED_VERYLOW(PK15))

#define VAL_GPIOK_PUPDR                 (PIN_PUPDR_PULLDOWN(PK00) | \
					 PIN_PUPDR_PULLDOWN(PK01) | \
					 PIN_PUPDR_PULLDOWN(PK02) | \
					 PIN_PUPDR_PULLDOWN(PK03) | \
					 PIN_PUPDR_PULLDOWN(PK04) | \
					 PIN_PUPDR_PULLDOWN(PK05) | \
					 PIN_PUPDR_PULLDOWN(PK06) | \
					 PIN_PUPDR_PULLDOWN(PK07) | \
					 PIN_PUPDR_PULLDOWN(PK08) | \
					 PIN_PUPDR_PULLDOWN(PK09) | \
					 PIN_PUPDR_PULLDOWN(PK10) | \
					 PIN_PUPDR_PULLDOWN(PK11) | \
					 PIN_PUPDR_PULLDOWN(PK12) | \
					 PIN_PUPDR_PULLDOWN(PK13) | \
					 PIN_PUPDR_PULLDOWN(PK14) | \
					 PIN_PUPDR_PULLDOWN(PK15))

#define VAL_GPIOK_ODR                   (PIN_ODR_LEVEL_LOW(PK00) | \
					 PIN_ODR_LEVEL_LOW(PK01) | \
					 PIN_ODR_LEVEL_LOW(PK02) | \
					 PIN_ODR_LEVEL_LOW(PK03) | \
					 PIN_ODR_LEVEL_LOW(PK04) | \
					 PIN_ODR_LEVEL_LOW(PK05) | \
					 PIN_ODR_LEVEL_LOW(PK06) | \
					 PIN_ODR_LEVEL_LOW(PK07) | \
					 PIN_ODR_LEVEL_LOW(PK08) | \
					 PIN_ODR_LEVEL_LOW(PK09) | \
					 PIN_ODR_LEVEL_LOW(PK10) | \
					 PIN_ODR_LEVEL_LOW(PK11) | \
					 PIN_ODR_LEVEL_LOW(PK12) | \
					 PIN_ODR_LEVEL_LOW(PK13) | \
					 PIN_ODR_LEVEL_LOW(PK14) | \
					 PIN_ODR_LEVEL_LOW(PK15))

#define VAL_GPIOK_AFRL			(PIN_AFIO_AF(PK00, 0) | \
					 PIN_AFIO_AF(PK01, 0) | \
					 PIN_AFIO_AF(PK02, 0) | \
					 PIN_AFIO_AF(PK03, 0) | \
					 PIN_AFIO_AF(PK04, 0) | \
					 PIN_AFIO_AF(PK05, 0) | \
					 PIN_AFIO_AF(PK06, 0) | \
					 PIN_AFIO_AF(PK07, 0))

#define VAL_GPIOK_AFRH			(PIN_AFIO_AF(PK08, 0) | \
					 PIN_AFIO_AF(PK09, 0) | \
					 PIN_AFIO_AF(PK10, 0) | \
					 PIN_AFIO_AF(PK11, 0) | \
					 PIN_AFIO_AF(PK12, 0) | \
					 PIN_AFIO_AF(PK13, 0) | \
					 PIN_AFIO_AF(PK14, 0) | \
					 PIN_AFIO_AF(PK15, 0))

#define AF_PA02_LCD_TX                   7U
#define AF_LINE_LCD_TX                   7U
#define AF_PA03_LCD_RX                   7U
#define AF_LINE_LCD_RX                   7U
#define AF_PA06_ENC_A                    2U
#define AF_LINE_ENC_A                    2U
#define AF_PA07_ENC_B                    2U
#define AF_LINE_ENC_B                    2U
#define AF_PA11_USB_DM                   10U
#define AF_LINE_USB_DM                   10U
#define AF_PA12_USB_DP                   10U
#define AF_LINE_USB_DP                   10U
#define AF_PA13_SWDIO                    0U
#define AF_LINE_SWDIO                    0U
#define AF_PA14_SWCLK                    0U
#define AF_LINE_SWCLK                    0U
#define AF_PB06_TX485                    7U
#define AF_LINE_TX485                    7U
#define AF_PB07_RS485                    7U
#define AF_LINE_RS485                    7U
#define AF_PB08_I2C1_SCL                 4U
#define AF_LINE_I2C1_SCL                 4U
#define AF_PB09_I2C1_SDA                 4U
#define AF_LINE_I2C1_SDA                 4U
#define AF_PB10_I2C2_SCL                 4U
#define AF_LINE_I2C2_SCL                 4U
#define AF_PB11_I2C2_SDA                 4U
#define AF_LINE_I2C2_SDA                 4U
#define AF_PC06_UART6_TX                 8U
#define AF_LINE_UART6_TX                 8U
#define AF_PC07_UART6_RX                 8U
#define AF_LINE_UART6_RX                 8U
#define AF_PC08_SD_D0                    12U
#define AF_LINE_SD_D0                    12U
#define AF_PC09_SD_D1                    12U
#define AF_LINE_SD_D1                    12U
#define AF_PC10_SD_D2                    12U
#define AF_LINE_SD_D2                    12U
#define AF_PC11_SD_D3                    12U
#define AF_LINE_SD_D3                    12U
#define AF_PC12_SD_CK                    12U
#define AF_LINE_SD_CK                    12U
#define AF_PC14_OSC32_IN                 0U
#define AF_LINE_OSC32_IN                 0U
#define AF_PD02_SD_CMD                   12U
#define AF_LINE_SD_CMD                   12U
#define AF_PH00_OSC_IN                   0U
#define AF_LINE_OSC_IN                   0U



#define BOARD_GROUP_DECLFOREACH(line, group) \
  static const ioline_t group ## _ARRAY[] = {group}; \
  for (ioline_t i=0, line =  group ## _ARRAY[i]; (i < group ## _SIZE) && (line = group ## _ARRAY[i]); i++)

#define BOARD_GROUP_FOREACH(line, group) \
  for (ioline_t i=0, line =  group ## _ARRAY[i]; (i < group ## _SIZE) && (line = group ## _ARRAY[i]); i++)


#define BOARD_GROUP_DECLFOR(array, index, group)  \
  static const ioline_t group ## _ARRAY[] = {group};    \
  for (ioline_t index=0, *array =  (ioline_t *) group ## _ARRAY; index < group ## _SIZE; index++)

#define BOARD_GROUP_FOR(array, index, group)  \
  for (ioline_t index=0, *array =  (ioline_t *) group ## _ARRAY; index < group ## _SIZE; index++)

#if !defined(_FROM_ASM_)
#ifdef __cplusplus
extern "C" {
#endif
  void boardInit(void);
#ifdef __cplusplus
}
#endif
#endif /* _FROM_ASM_ */
