Fabien-B/soufflerie_dashboard/firmware/source/sensors.cpp

#include "sensors.h"
#include "hal.h"
#include "ch.h"
#include "stdutil++.hpp"
extern "C" {
    #include "i2cPeriphBMP3XX.h"
    #include "i2cPeriphSDP3X.h"
    #include "i2cPeriphSHT4x.h"
}

// Digital noise filter: 0 disabled, [0x1 - 0xF] enable up to n t_I2CCLK
#define STM32_CR1_DNF(n)          ((n & 0x0f) << 8)

I2CConfig i2c1_conf = {
    .timingr = 0x0080195B,      // 50ns rise time, 10ns fall time, DNF=2 (au pif)
    .cr1 = STM32_CR1_DNF(2),    // au pif
    .cr2 = 0
};

I2CConfig i2c2_conf = {
    .timingr = 0x0080195B,      // 50ns rise time, 10ns fall time, DNF=2 (au pif)
    .cr1 = STM32_CR1_DNF(2),    // au pif
    .cr2 = 0
};



#pragma GCC diagnostic push
#pragma GCC diagnostic ignored "-Wmissing-field-initializers"
Bmp3xxConfig bmp3_conf = {
    .i2cp = &I2CD1,
    .slaveAddr = BMP3_ADDR_I2C_PRIM,
    .settings = {
        .op_mode =BMP3_MODE_NORMAL,
        .press_en = BMP3_ENABLE,
        .temp_en = BMP3_ENABLE,
        .odr_filter = {
            .press_os = BMP3_OVERSAMPLING_32X,
            .temp_os = BMP3_OVERSAMPLING_2X,
            .odr = BMP3_ODR_12_5_HZ // BMP3_ODR_6_25_HZ BMP3_ODR_200_HZ
            },
    },
    .settings_sel = BMP3_SEL_PRESS_EN | BMP3_SEL_TEMP_EN | BMP3_SEL_PRESS_OS |
                    BMP3_SEL_TEMP_OS | BMP3_SEL_ODR /* | BMP3_SEL_DRDY_EN*/
};
#pragma GCC diagnostic pop


Sdp3xDriver  IN_DMA_SECTION(sdp);
Sht4xDriver  IN_DMA_SECTION(sht);
Bmp3xxDriver IN_DMA_SECTION(bmp3);

static IN_DMA_SECTION(THD_WORKING_AREA(waSensors, 2048));

static void sensorsThd(void*) {
    chRegSetThreadName("sensorsThd");

    i2cStart(&I2CD1, &i2c1_conf);
    i2cStart(&I2CD2, &i2c2_conf);

    if(bmp3xxStart(&bmp3, &bmp3_conf) == MSG_OK) {
        //DebugTrace ("bmp init OK");
    } else {
        DebugTrace ("bmp init FAIL");
    }


    sdp3xStart(&sdp, &I2CD1, SDP3X_ADDRESS1);
    sdp3xStop(&sdp);
    // get scale
    sdp3xRequest(&sdp, SDP3X_pressure_temp_scale_oneshot);
    sdp3xFetch(&sdp, SDP3X_pressure_temp_scale_oneshot);
    // request continuous pressure
    sdp3xRequest(&sdp, SDP3X_pressure_temp);

    sht4xStart(&sht, &I2CD2, SHT4X_ADDRESS1);

    sht4xSend(&sht, SHT4x_READ_IDENT);
    sht4xFetch(&sht);
    

    while(true) {
        if (bmp3xxFetch(&bmp3, BMP3_PRESS | BMP3_TEMP) != MSG_OK) {
            DebugTrace ("bmp fetch FAIL");
        }


        if(sdp3xFetch(&sdp, SDP3X_pressure_temp) != MSG_OK) {
            DebugTrace ("SDP31 fetch FAIL");
        }


        if(sht4xSend(&sht, SHT4x_TEMP_RH_HI) == MSG_OK) {
            chThdSleepMilliseconds(10);
            if(sht4xFetch(&sht) != MSG_OK) {
                DebugTrace ("SHT45 fetch command failed");
            }
        } else {
            DebugTrace ("SHT45 send command failed");
        }
        

        chThdSleepMilliseconds(500);
    }

}


float getTemp() {
    return bmp3xxGetTemp(&bmp3);
}

float getAbsolutePressure() {
    return bmp3xxGetPressure(&bmp3)/100.0f;
}

float getDiffPressure() {
    return sdp3xGetPressure(&sdp);
}

float getTunnelTemp()
{
    return sht4xGetTemp(&sht);
}

float getAirspeed()
{
    // TODO calculer airspeed
    return getDiffPressure() + 12 + getTunnelTemp()/10.0;
}

void startSensors() {
    chThdCreateStatic(waSensors, sizeof(waSensors), NORMALPRIO + 1, sensorsThd, NULL);
}
