Fabien-B/soufflerie_dashboard/(commit log)

2024-04-10 Add HSE oscillator
    [soufflerie.kicad_sch]
2024-04-10 select DB9 footprint
    [soufflerie.kicad_sch]
2024-04-11 connect SDP31 DIE pad
    [soufflerie.kicad_pcb, soufflerie.kicad_sch]
2024-04-11 add sensor probe
    [soufflerie.kicad_pcb, soufflerie.kicad_sch]
2024-04-11 add a few vias
    [soufflerie.kicad_pcb]
2024-04-11 fix unconnected pad.
    [soufflerie.kicad_pcb]
2024-04-11 Panelize boards
    [panel_soufflerieV2.kicad_pcb]
2024-11-19 start firmware
    [board.cfg]
2024-11-19 Add driver for SHT4x
2024-11-19 Display tunnel temperature.
2024-11-20 Add SD card support
    [board.cfg]
2024-11-21 Start USS driver.
2024-11-21 [USS] Put drivers config in USSConfig.
2024-11-21 [USS] move configs and drivers where they belong.
2024-11-21 [USS] stop uart receive on residual timeout.
2024-11-22 remove traces
2024-11-29 Fix UART config
2024-12-02 USS Log and RS485 TX working
    [board.cfg]
